sarimabbas/cpsc334-module-4/(list of files, drawings)

Other design files:
docs/schematic.fzz
